nostradomus/LHCreate-2017/pdf-files/modules-graphical_design.pdf

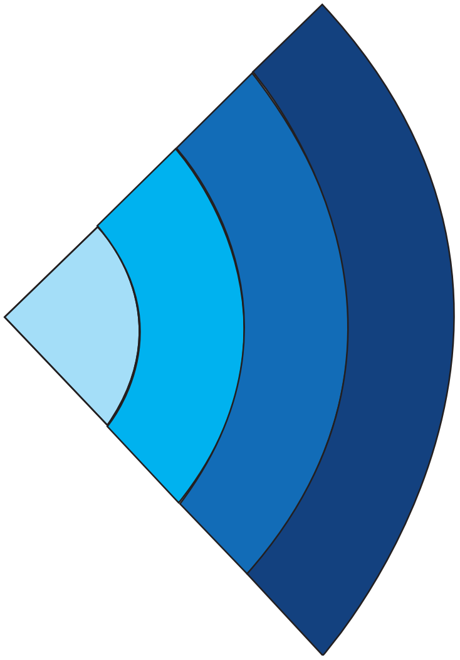
[picture p11: figure]
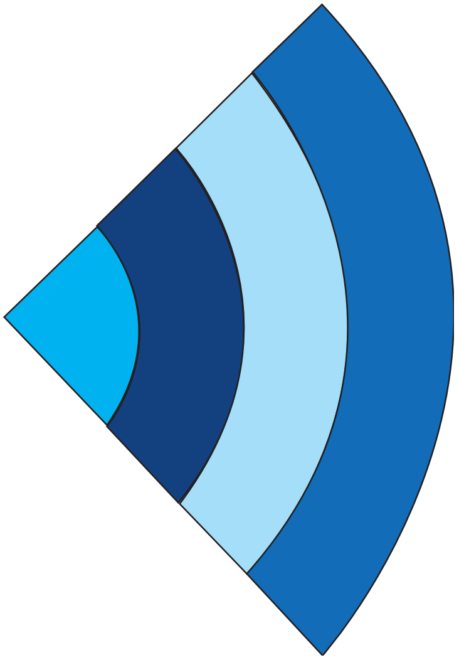
[picture p12: figure]
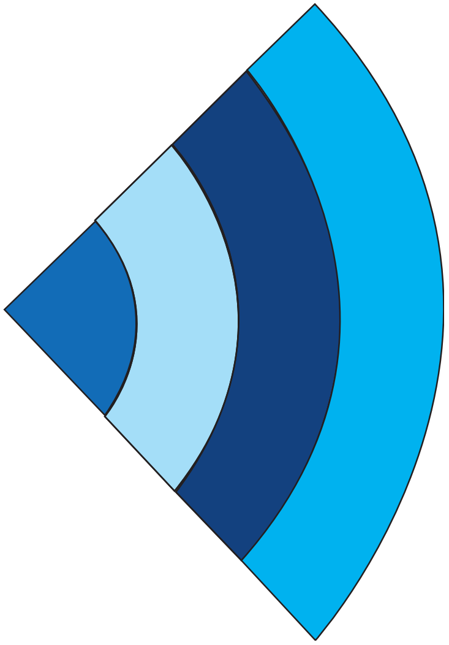
[picture p13: figure]
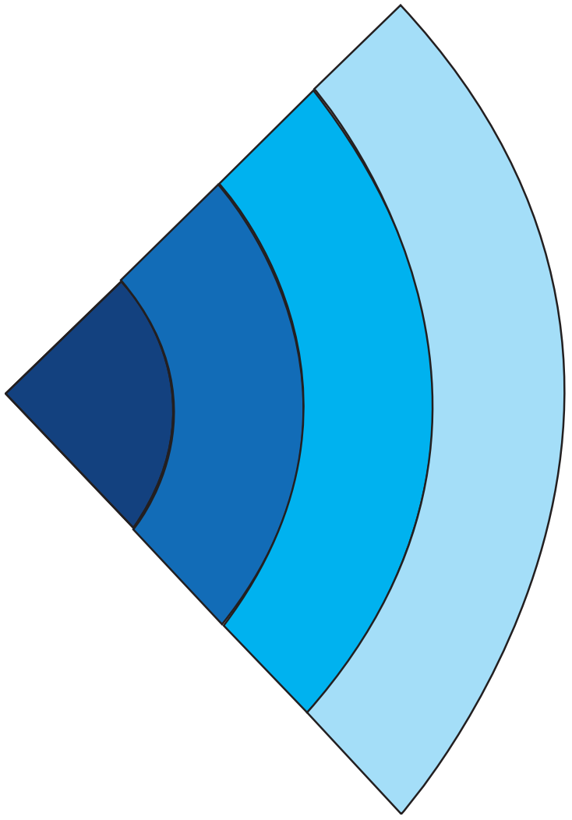
[picture p14: figure]

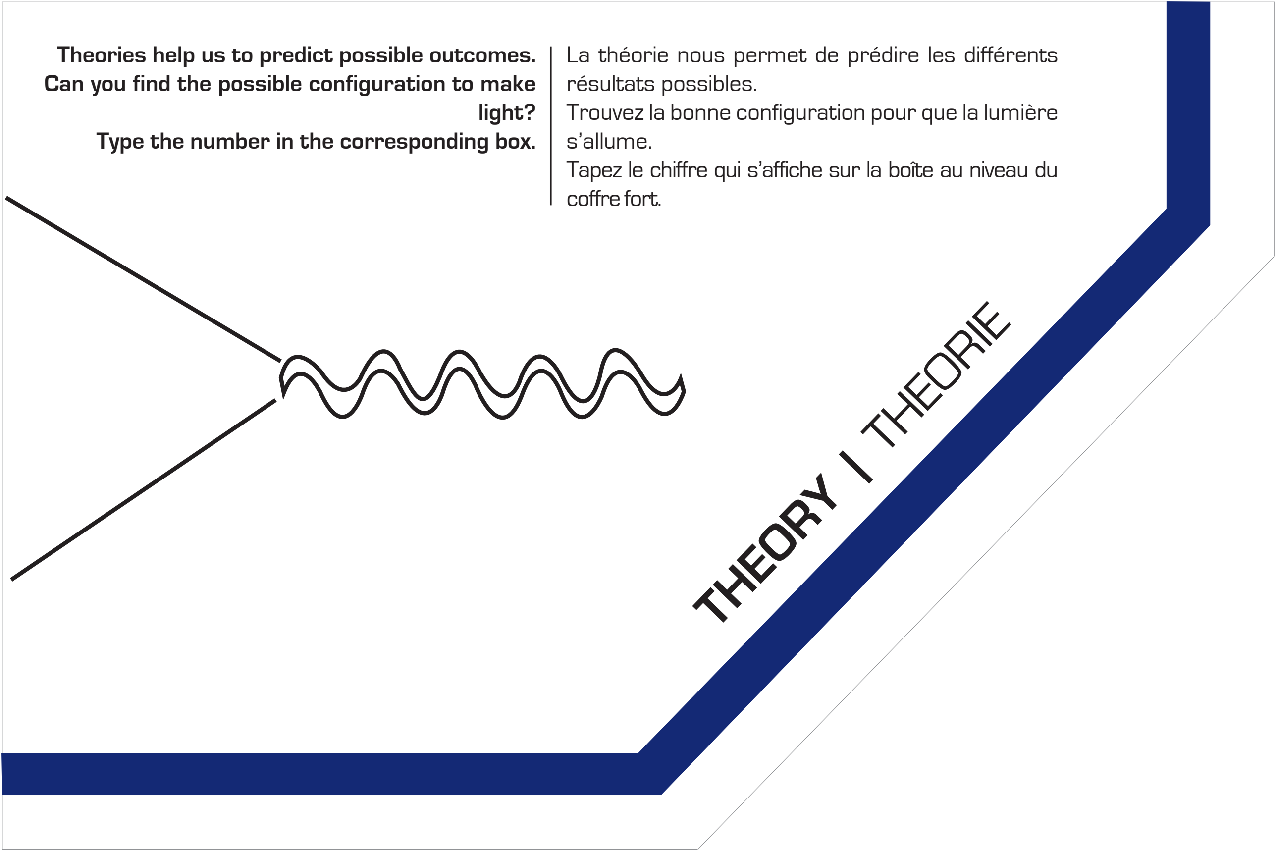
[picture p15: figure]
THEORY | THEORIE; light?; résultats possibles.; s’allume.; coffre fort.

Theories help us to predict possible outcomes. Can you find the possible configuration to make

Type the number in the corresponding box.

La théorie nous permet de prédire les différents

Trouvez la bonne configuration pour que la lumière

Tapez le chiffre qui s’affiche sur la boîte au niveau du

Try to remove the background from the signal by moving the pictures over each other. You will see the number of the corresponding box as a signal.

Essayez d’enlever le bruit de fond du signal en bougeant les images l’une sur l’autre.
Vous verrez apparaître le chiffre à reporter au niveau du coffre.

# RESULTS | RESULTATS

# ACCELERATORS | ACCELERATEURS

Accelerate the particles.
Be careful to choose the right energy. Type the number in the corresponding box.

Accélérez les particules !
Faites attention d’utiliser la bonne énergie. Tapez le chiffre sur la boîte correspondante au niveau du coffre fort.

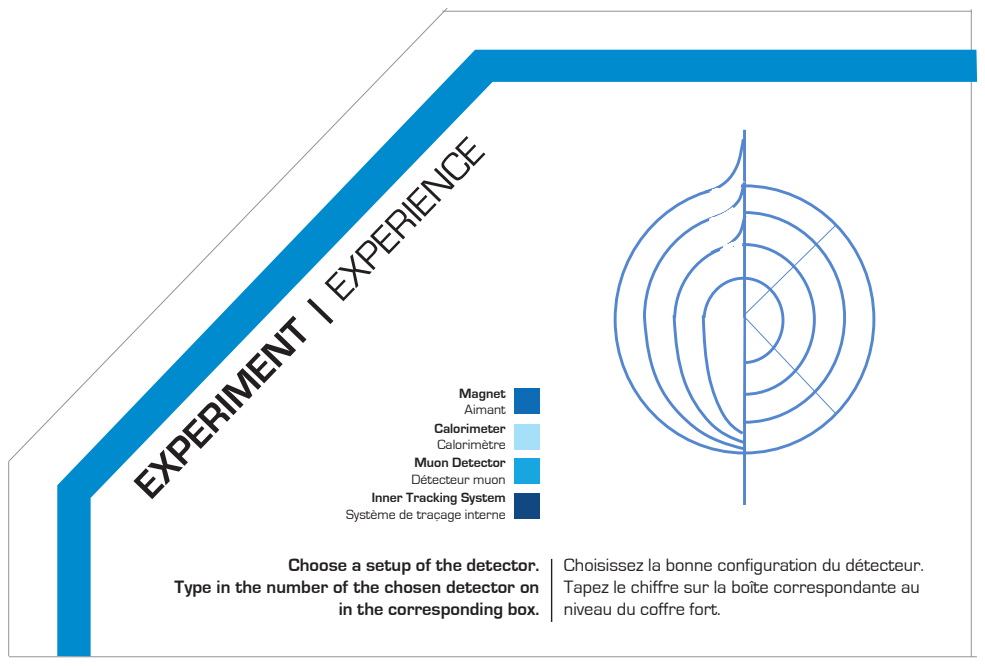
[picture p16: page 9]
EXPERIMENT | EXPERIENCE

Magnet
Aimant
Calorimeter
Calorimètre
Muon Detector
Détecteur muon
Inner Tracking System
Système de traçage interne

Choose a setup of the detector.

Choisissez la bonne configuration du détecteur.
Tapez le chiffre sur la boîte correspondante au
niveau du coffre fort.

Type in the number of the chosen detector on

in the corresponding box.

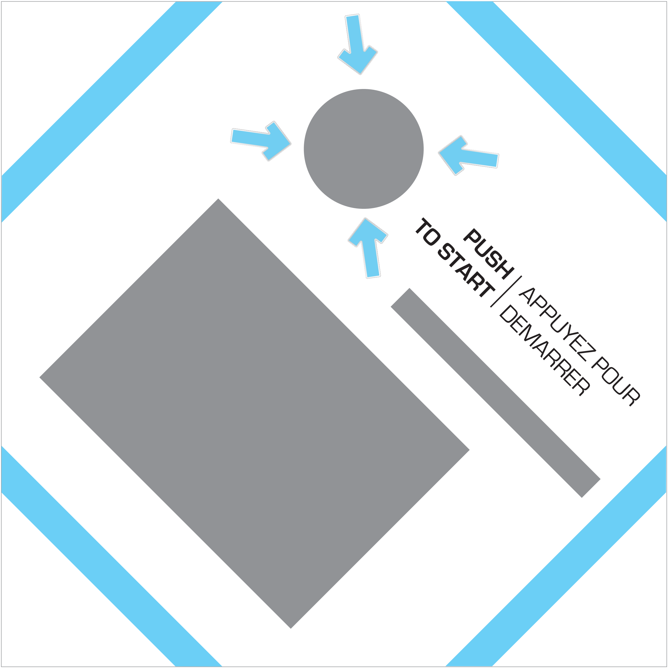
[picture p17: figure]
APPUYEZ POUR DEMARRER; PUSH; TO START
