nostradomus/LHCreate-2017/images/controller-board_board-s.png

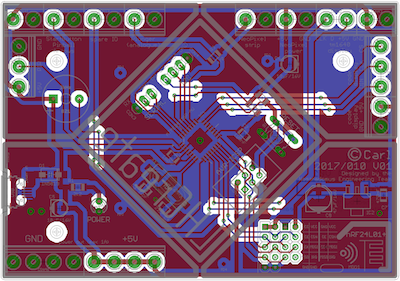
images/controller-board_board-s.png
