nostradomus/LHCreate-2017/images/controller-board_pcb.png

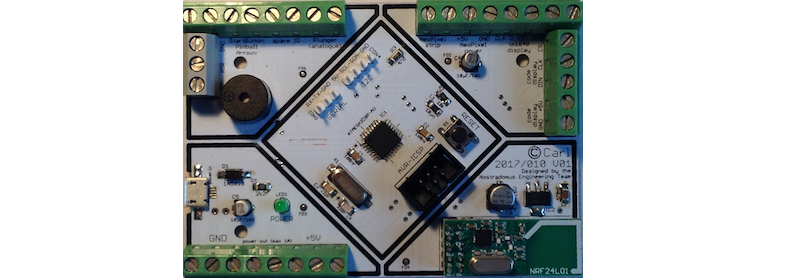
images/controller-board_pcb.png
