nostradomus/LHCreate-2017/images/front.png

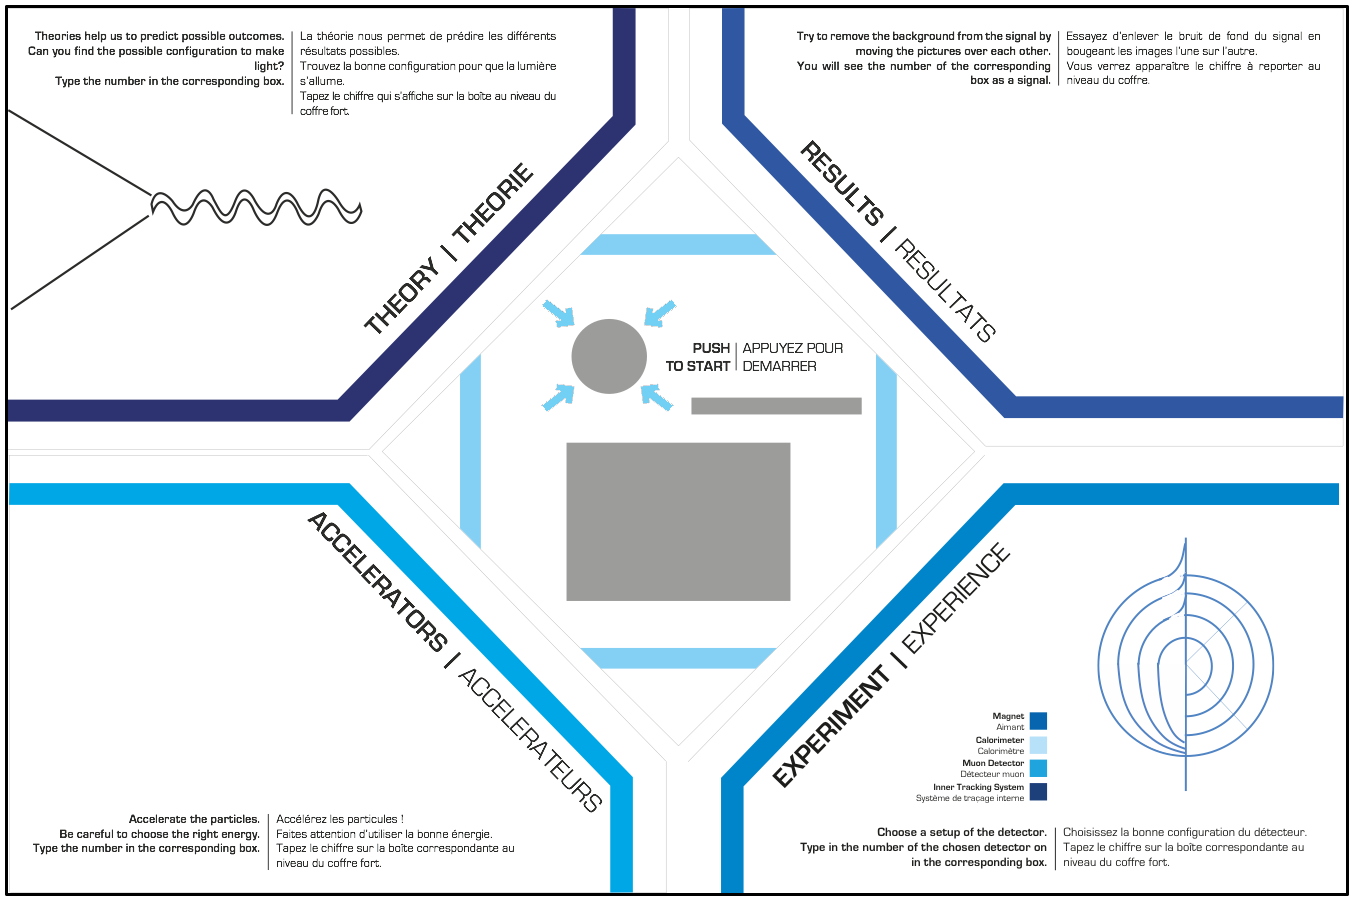
images/front.png
