nostradomus/LHCreate-2017/images/USBprogrammershield_schematic.png

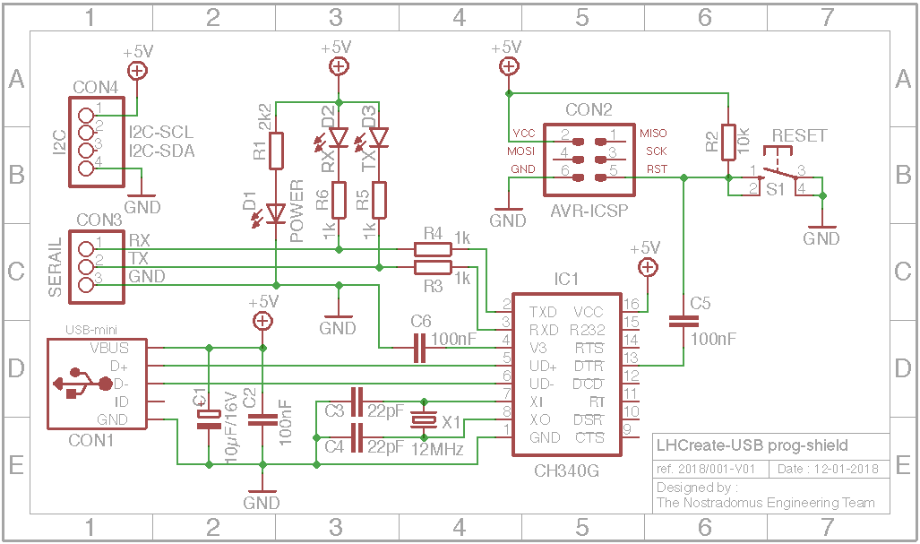
images/USBprogrammershield_schematic.png
